arvvoid/amiga.undead/images/image15.jpg

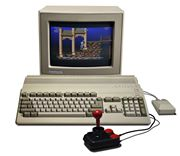
images/image15.jpg
