arvvoid/amiga.undead/(commit log)

2024-11-09 Update amiga_led_control_odroid.c
    Refactor and correct and update code
    [amiga_led_control_odroid.c]
2024-11-09 Update build-led-control.yml
    correct action
2024-11-09 Configure submodule Amiga500-USB-Keyboard-Leonardo to track latest commit on branch main
2024-11-14 Update Amiga500 Keyboard Arduino Leonardo sketch
